Kulicheg/ATM2IOESP/Datasheets/wemos_D1_Mini_ESP32_pinout.jpg

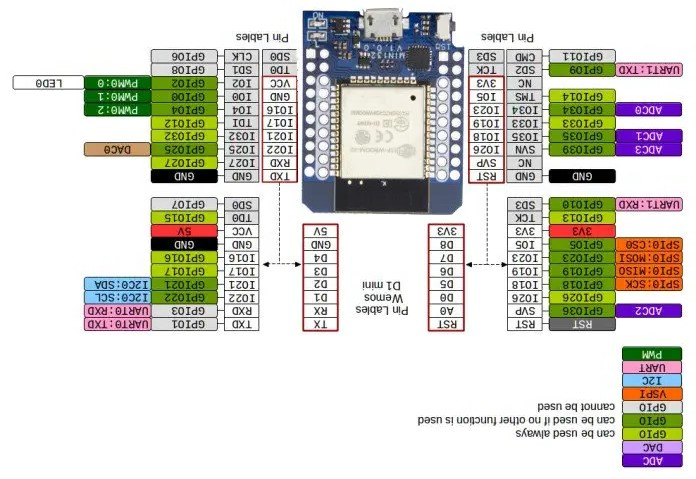
Datasheets/wemos_D1_Mini_ESP32_pinout.jpg
