Kulicheg/ATM2IOESP/PCB/pcb.jpg

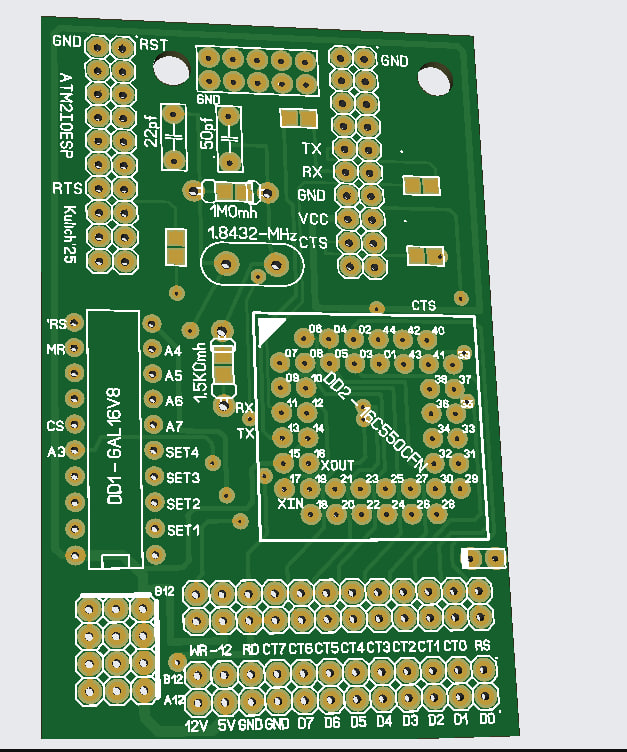
PCB/pcb.jpg
