Kulicheg/ATM2IOESP/PCB/esp32-boot.PNG

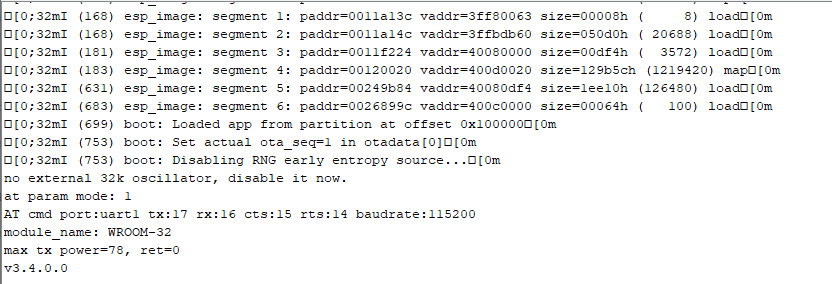
PCB/esp32-boot.PNG
