Kulicheg/ATM2IOESP/PCB/esp32-prog.PNG

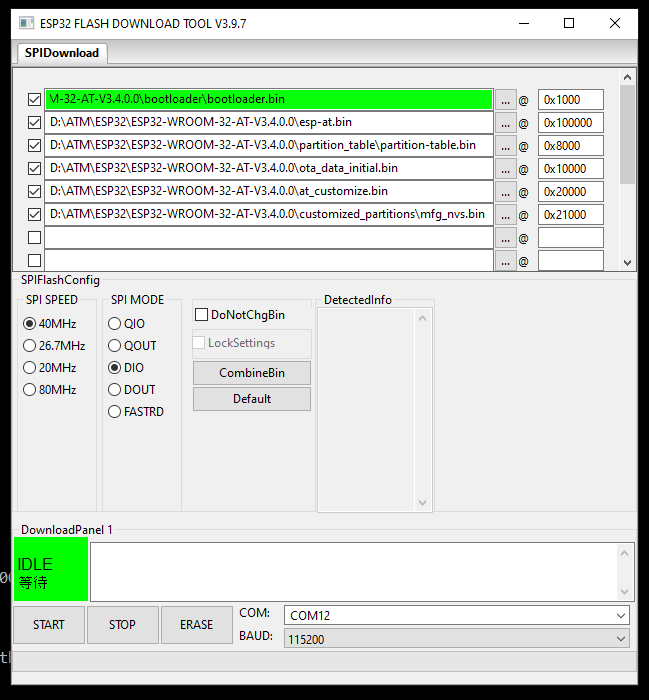
PCB/esp32-prog.PNG
