Kulicheg/ATM2IOESP/PCB/pcb_rev02.PNG

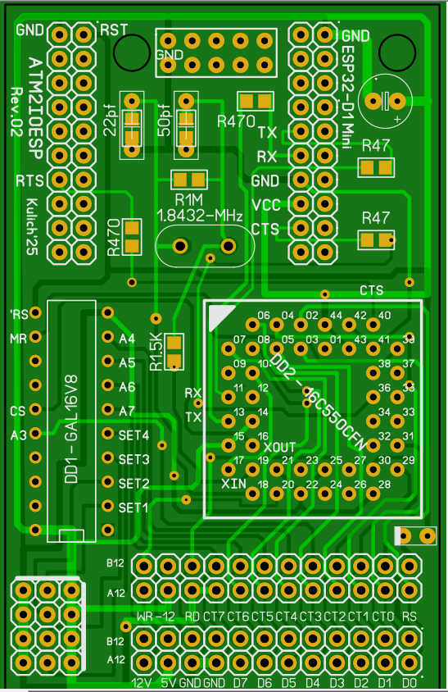
PCB/pcb_rev02.PNG
