Kulicheg/ATM2IOESP/(list of files, drawings)

Other design files:
PCB/ATM2IOESP Rev2.lay6
PCB/ATM2IOESP.lay6
