Kulicheg/ATM2IOESP/(commit log)

2025-01-07 work in progress backup
    [ATM2IOESP.lay6]
2025-03-09 update pcb and pld
    [ATM2IOESP.lay6]
2025-03-15 PCB last touches
    [ATM2IOESP.lay6]
2025-03-16 added gerbers
    [ATM2IOESP.lay6]
2025-04-19 Плата Rev 02
    В первой ревизии фатальных ошибок нет, Во второй ревизии увеличены монтажные отверстия под IDC и PLCC для упрощения монтажа. Нанесена шелкография номиналов резисторов, подвинут блок джамперов к краю платы.
    [ATM2IOESP Rev2.lay6, ATM2IOESP.lay6]
2025-05-07 Смена порта с F8 на F0
2025-05-24 Небольшие изменения
    Добавлен электролит на питании.
    [ATM2IOESP Rev2.lay6]
2025-06-30 Обновление инструкции/мелкие правки
    [ATM2IOESP Rev2.lay6]
2026-03-21 Обновление
2026-11-09 доки
